AlexanderKnapik/DivaConGold/harness/samducksa_white.png

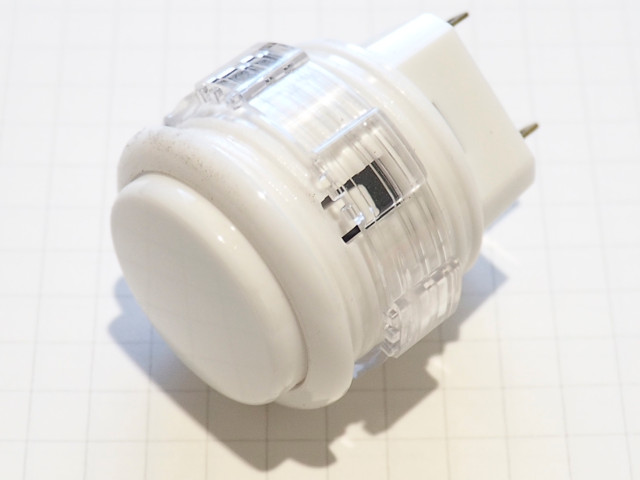
harness/samducksa_white.png
