AlexanderKnapik/DivaConGold/harness/samducksa_pink.png

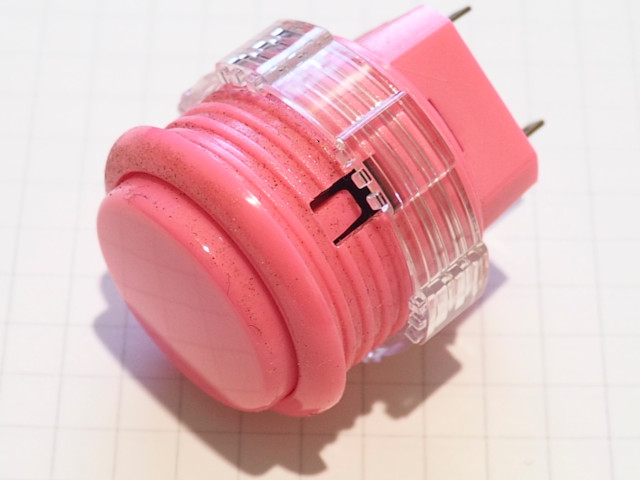
harness/samducksa_pink.png
