AlexanderKnapik/DivaConGold/harness/harness.png

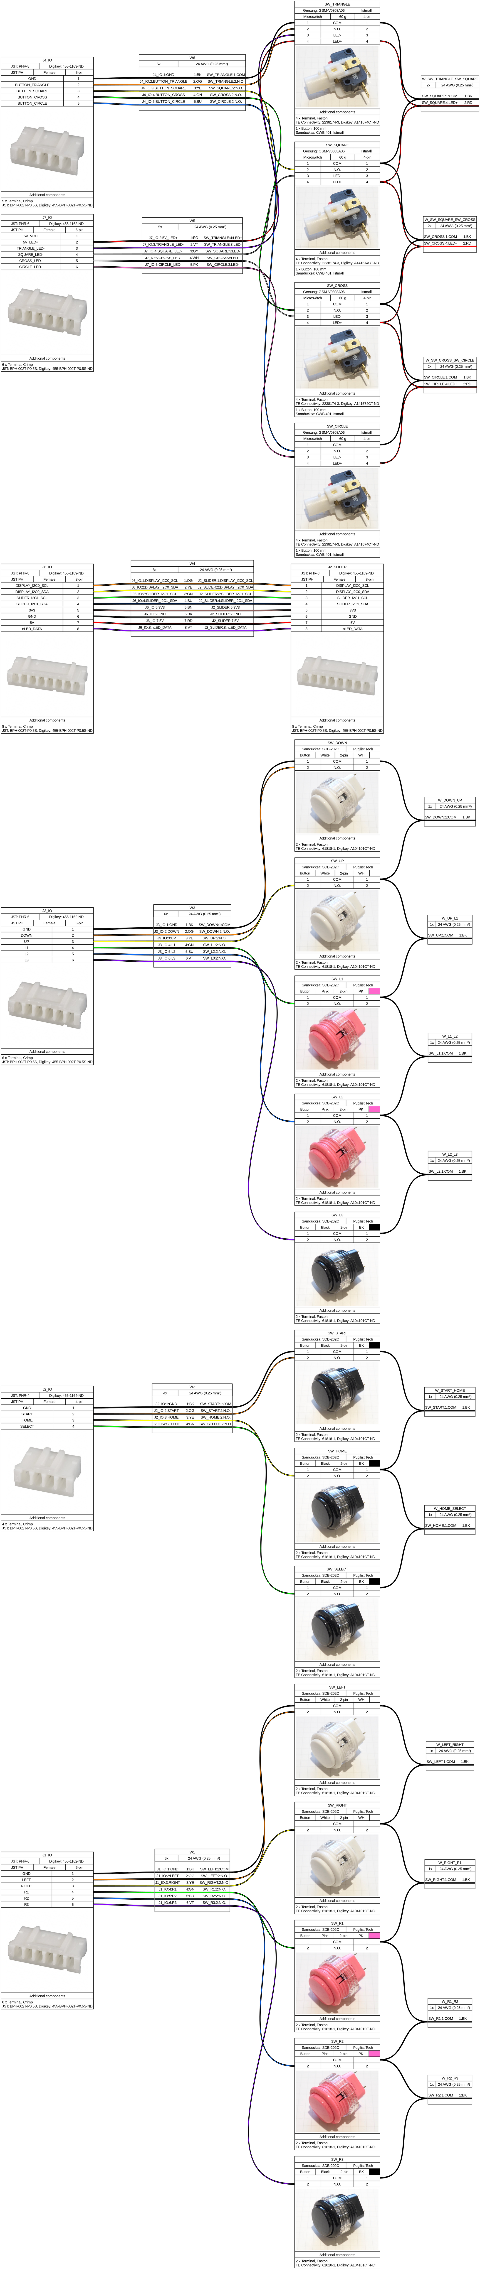
harness/harness.png
