AlexanderKnapik/DivaConGold/harness/microswitch.png

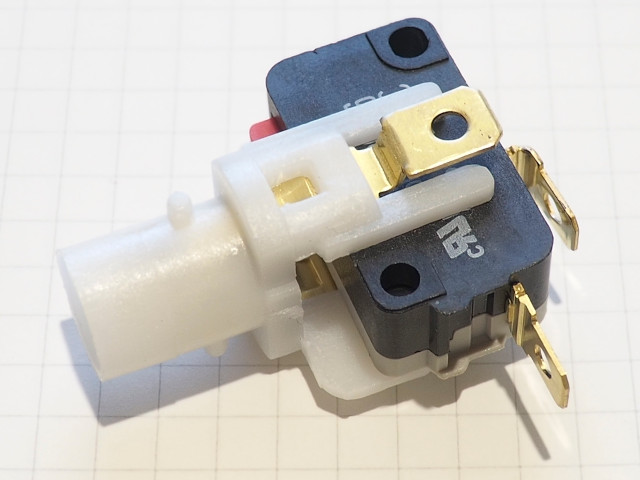
harness/microswitch.png
