AlexanderKnapik/DivaConGold/harness/samducksa_black.png

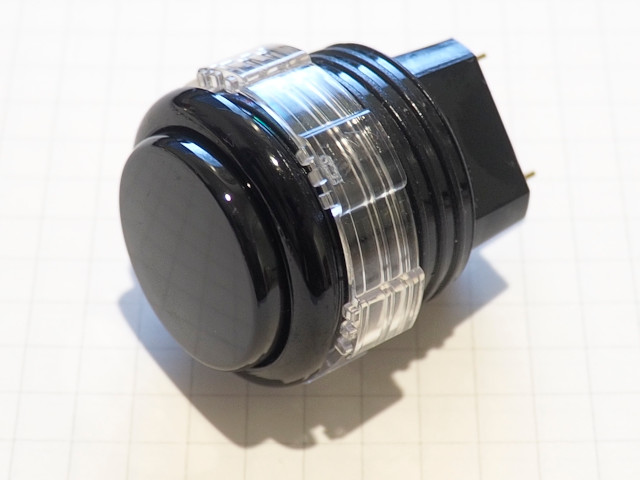
harness/samducksa_black.png
