AlexanderKnapik/DivaConGold/mech/DivaConGold.FCStd

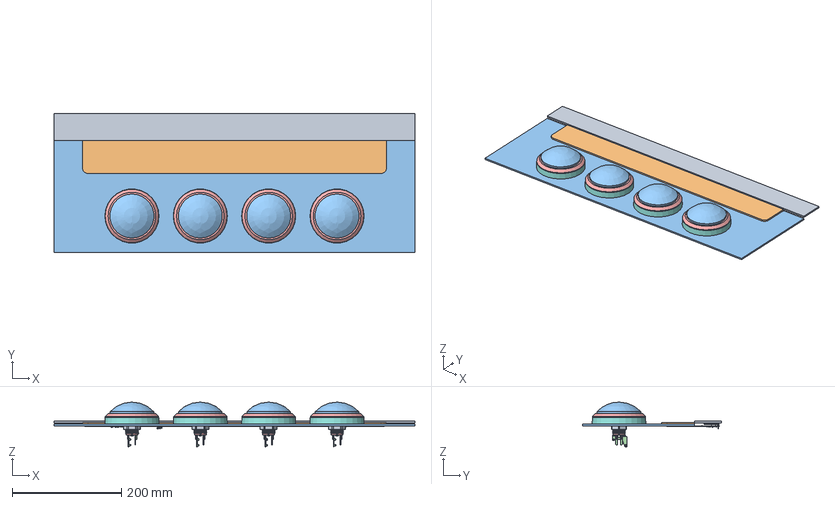
[picture p6: CAD file, 2025-12-05]
mech/DivaConGold.FCStd
660.0 x 255.0 x 82.0 mm
HeaderPlate
SliderPlate
FacePlate
C_0603_1608Metric
C_0603_1608Metric001
C_0603_1608Metric002
C_0603_1608Metric003
C_0603_1608Metric004
C_0603_1608Metric005
C_0603_1608Metric006
C_0603_1608Metric007
C_0603_1608Metric008
C_0603_1608Metric009
C_0603_1608Metric010
C_0603_1608Metric011
C_0603_1608Metric012
C_0603_1608Metric013
C_0603_1608Metric014
C_0603_1608Metric015
C_0603_1608Metric016
C_0603_1608Metric017
C_0603_1608Metric018
R_0603_1608Metric
C_0603_1608Metric019
C_0603_1608Metric020
C_0603_1608Metric021
C_0603_1608Metric022
C_0603_1608Metric023
C_0603_1608Metric024
C_0603_1608Metric025
C_0603_1608Metric026
C_0603_1608Metric027
C_0603_1608Metric028
C_0603_1608Metric029
C_0603_1608Metric030
C_0603_1608Metric031
C_0603_1608Metric032
C_0603_1608Metric033
C_0603_1608Metric034
C_0603_1608Metric035
C_0603_1608Metric036
C_0603_1608Metric037
C_0603_1608Metric038
C_0603_1608Metric039
C_0603_1608Metric040
C_0603_1608Metric041
C_0603_1608Metric042
C_0603_1608Metric043
C_0603_1608Metric044
C_0603_1608Metric045
C_0603_1608Metric046
C_0603_1608Metric047
C_0603_1608Metric048
C_0603_1608Metric049
C_0603_1608Metric050
C_0603_1608Metric051
C_0603_1608Metric052
C_0603_1608Metric053
C_0603_1608Metric054
C_0603_1608Metric055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
