AlexanderKnapik/DivaConGold/pcb/DivaConSlider/DivaConSlider.kicad_pcb

## KiCad design pcb/DivaConSlider/DivaConSlider.kicad_pcb (2025-12-05)

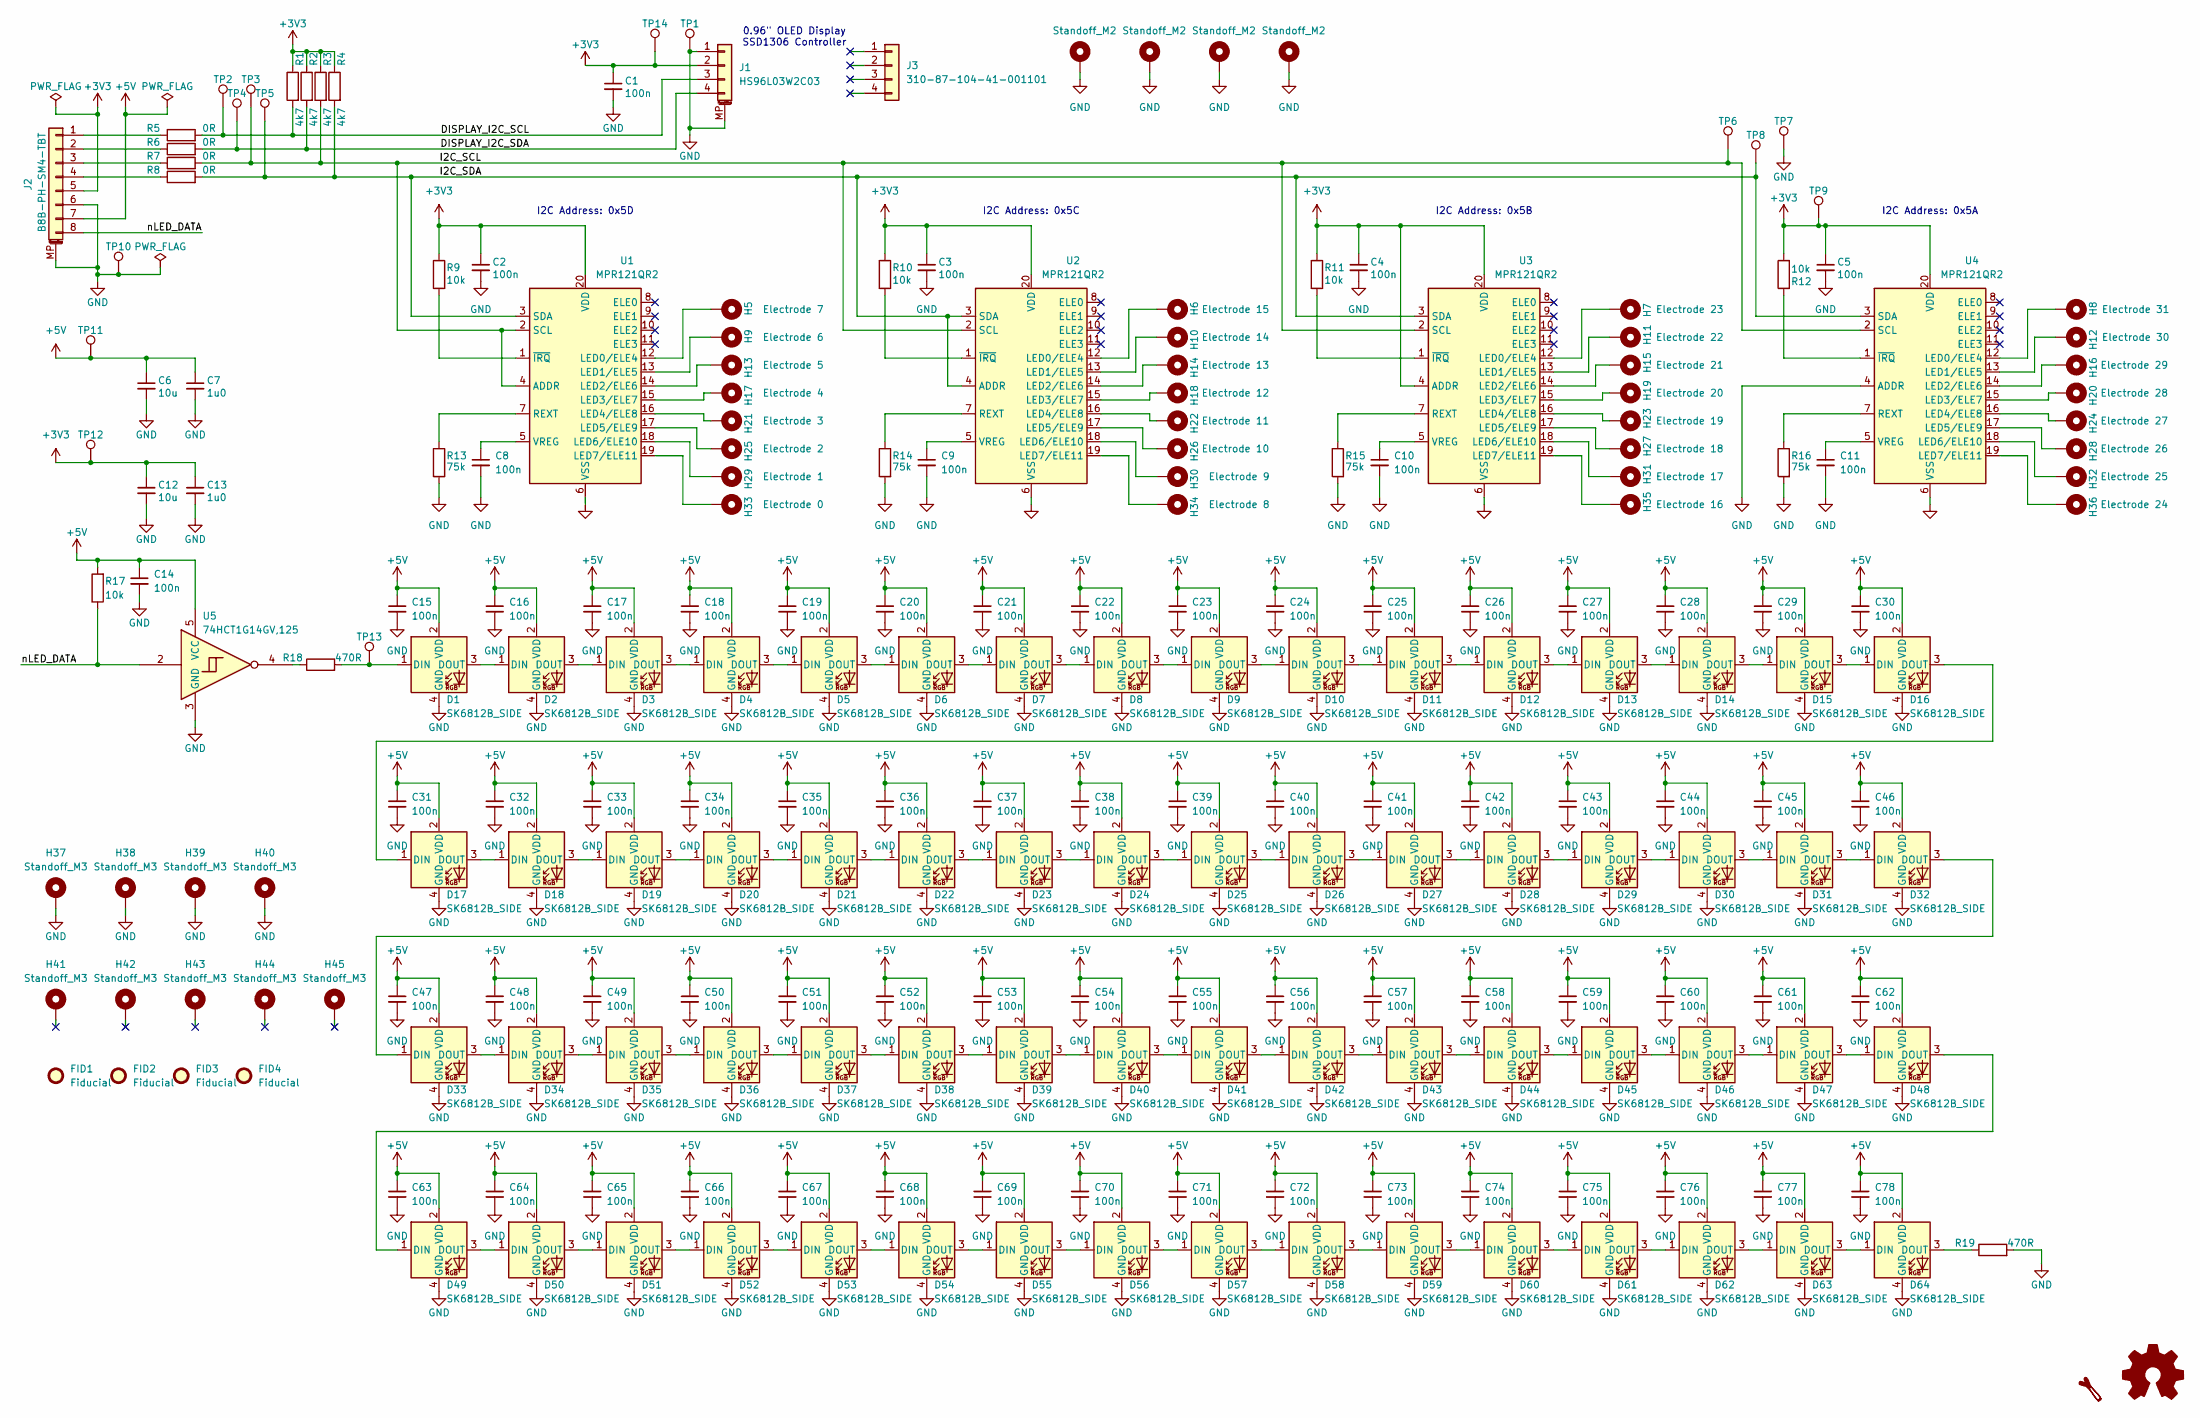
[picture p8: schematic DivaConSlider.kicad_sch, DivaConGold Slider]

Parts:
C1, C2, C3, C4, C5, C8, C9, C10, C11, C14, C15, C16, C17, C18, C19, C20, C21, C22, C23, C24, C25, C26, C27, C28, C29, C30, C31, C32, C33, C34, C35, C36, C37, C38, C39, C40, C41, C42, C43, C44, C45, C46, C47, C48, C49, C50, C51, C52, C53, C54, C55, C56, C57, C58, C59, C60, C61, C62, C63, C64, C65, C66, C67, C68, C69, C70, C71, C72, C73, C74, C75, C76, C77, C78: 100n; C_0603_1608Metric; Voltage 50V; PartNumber CL10B104KB8NNNC
C6, C12: 10u; C_0805_2012Metric; Voltage 16V; PartNumber CL21B106KOQNNNE
C7, C13: 1u0; C_0603_1608Metric; Voltage 16V; PartNumber CL10B105KO8NNNC
D1, D2, D3, D4, D5, D6, D7, D8, D9, D10, D11, D12, D13, D14, D15, D16, D17, D18, D19, D20, D21, D22, D23, D24, D25, D26, D27, D28, D29, D30, D31, D32, D33, D34, D35, D36, D37, D38, D39, D40, D41, D42, D43, D44, D45, D46, D47, D48, D49, D50, D51, D52, D53, D54, D55, D56, D57, D58, D59, D60, D61, D62, D63, D64: SK6812B_SIDE; LED_SK6812B_SIDE; PartNumber SK6812SIDE-A
FID1, FID2, FID3, FID4: Fiducial; Fiducial_0.5mm_Mask1.5mm
H1, H2, H3, H4: Standoff_M2; MountingHole_2.2mm_M2_Pad
H5: Electrode 7; Touchpad_15mmx42mm
H6: Electrode 15; Touchpad_15mmx42mm
H7: Electrode 23; Touchpad_15mmx42mm
H8: Electrode 31; Touchpad_15mmx42mm
H9: Electrode 6; Touchpad_15mmx42mm
H10: Electrode 14; Touchpad_15mmx42mm
H11: Electrode 22; Touchpad_15mmx42mm
H12: Electrode 30; Touchpad_15mmx42mm
H13: Electrode 5; Touchpad_15mmx42mm
H14: Electrode 13; Touchpad_15mmx42mm
H15: Electrode 21; Touchpad_15mmx42mm
H16: Electrode 29; Touchpad_15mmx42mm
H17: Electrode 4; Touchpad_15mmx42mm
H18: Electrode 12; Touchpad_15mmx42mm
H19: Electrode 20; Touchpad_15mmx42mm
H20: Electrode 28; Touchpad_15mmx42mm
H21: Electrode 3; Touchpad_15mmx42mm
H22: Electrode 11; Touchpad_15mmx42mm
H23: Electrode 19; Touchpad_15mmx42mm
H24: Electrode 27; Touchpad_15mmx42mm
H25: Electrode 2; Touchpad_15mmx42mm
H26: Electrode 10; Touchpad_15mmx42mm
H27: Electrode 18; Touchpad_15mmx42mm
H28: Electrode 26; Touchpad_15mmx42mm
H29: Electrode 1; Touchpad_15mmx42mm
H30: Electrode 9; Touchpad_15mmx42mm
H31: Electrode 17; Touchpad_15mmx42mm
H32: Electrode 25; Touchpad_15mmx42mm
H33: Electrode 0; Touchpad_15mmx42mm
H34: Electrode 8; Touchpad_15mmx42mm
H35: Electrode 16; Touchpad_15mmx42mm
H36: Electrode 24; Touchpad_15mmx42mm
H37, H38, H39, H40: Standoff_M3; MountingHole_3.2mm_M3_Pad_Via
H41, H42, H43, H44, H45: Standoff_M3; MountingHole_3.2mm_M3_Pad
J1: HS96L03W2C03; Hansheng_HS96L03W2C03; PartNumber HS96L03W2C03
J2: B8B-PH-SM4-TBT; JST_PH_B8B-PH-SM4-TB_1x08-1MP_P2.00mm_Vertical; PartNumber B8B-PH-SM4-TBT
J3: 310-87-104-41-001101; PinHeader_1x04_P2.54mm_Vertical; PartNumber 310-87-104-41-001101
R1, R2, R3, R4: 4k7; R_0603_1608Metric; PartNumber RMCF0603FT4K70
R5, R6, R7, R8: 0R; R_0603_1608Metric; PartNumber RMCF0603ZT0R00
R9, R10, R11, R12, R17: 10k; R_0603_1608Metric; PartNumber RMCF0603FT10K0
R13, R14, R15, R16: 75k; R_0603_1608Metric; PartNumber RMCF0603FT75K0
R18: 470R; R_0603_1608Metric; PartNumber RMCF0603FT470R
R19: 470R; R_0603_1608Metric
SYM1: Logo_Open_Hardware_Small; OSHW-Logo_5.7x6mm_SilkScreen
SYM2: Leek; Leek-Logo_6.3mm_Silkscreen
TP1, TP2, TP3, TP4, TP5, TP6, TP7, TP8, TP9, TP10, TP11, TP12, TP13, TP14: TestPoint; TestPoint_Pad_D1.5mm
U1, U2, U3, U4: MPR121QR2; UQFN-20_3x3mm_P0.4mm; PartNumber MPR121QR2
U5: 74HCT1G14GV,125; SC-74A-5_1.55x2.9mm_P0.95mm; PartNumber 74HCT1G14GV,125

Connections:
+3V3: C1.1, C2.1, C3.1, C4.1, C5.1, C12.1, C13.1, J1.2, J2.5, R1.1, R2.1, R3.1, R4.1, R9.1, R10.1, R11.1, R12.2, TP9.1, TP12.1, TP14.1, U1.20 (VDD), U2.20 (VDD), U3.4 (ADDR), U3.20 (VDD), U4.20 (VDD)
+5V: C6.1, C7.1, C14.1, C15.1, C16.1, C17.1, C18.1, C19.1, C20.1, C21.1, C22.1, C23.1, C24.1, C25.1, C26.1, C27.1, C28.1, C29.1, C30.1, C31.1, C32.1, C33.1, C34.1, C35.1, C36.1, C37.1, C38.1, C39.1, C40.1, C41.1, C42.1, C43.1, C44.1, C45.1, C46.1, C47.1, C48.1, C49.1, C50.1, C51.1, C52.1, C53.1, C54.1, C55.1, C56.1, C57.1, C58.1, C59.1, C60.1, C61.1, C62.1, C63.1, C64.1, C65.1, C66.1, C67.1, C68.1, C69.1, C70.1, C71.1, C72.1, C73.1, C74.1, C75.1, C76.1, C77.1, C78.1, D1.2 (VDD), D2.2 (VDD), D3.2 (VDD), D4.2 (VDD), D5.2 (VDD), D6.2 (VDD), D7.2 (VDD), D8.2 (VDD), D9.2 (VDD), D10.2 (VDD), D11.2 (VDD), D12.2 (VDD), D13.2 (VDD), D14.2 (VDD), D15.2 (VDD), D16.2 (VDD), D17.2 (VDD), D18.2 (VDD), D19.2 (VDD), D20.2 (VDD), D21.2 (VDD), D22.2 (VDD), D23.2 (VDD), D24.2 (VDD), D25.2 (VDD), D26.2 (VDD), D27.2 (VDD), D28.2 (VDD), D29.2 (VDD), D30.2 (VDD), D31.2 (VDD), D32.2 (VDD), D33.2 (VDD), D34.2 (VDD), D35.2 (VDD), D36.2 (VDD), D37.2 (VDD), D38.2 (VDD), D39.2 (VDD), D40.2 (VDD), D41.2 (VDD), D42.2 (VDD), D43.2 (VDD), D44.2 (VDD), D45.2 (VDD), D46.2 (VDD), D47.2 (VDD), D48.2 (VDD), D49.2 (VDD), D50.2 (VDD), D51.2 (VDD), D52.2 (VDD), D53.2 (VDD), D54.2 (VDD), D55.2 (VDD), D56.2 (VDD), D57.2 (VDD), D58.2 (VDD), D59.2 (VDD), D60.2 (VDD), D61.2 (VDD), D62.2 (VDD), D63.2 (VDD), D64.2 (VDD), J2.7, R17.2, TP11.1, U5.5 (VCC)
/DISPLAY_I2C_SCL: J1.3, R1.2, R5.2, TP2.1
/DISPLAY_I2C_SDA: J1.4, R2.2, R6.2, TP4.1
/I2C_SCL: R3.2, R7.2, TP3.1, TP6.1, U1.2 (SCL), U1.4 (ADDR), U2.2 (SCL), U3.2 (SCL), U4.2 (SCL)
/I2C_SDA: R4.2, R8.2, TP5.1, TP8.1, U1.3 (SDA), U2.3 (SDA), U2.4 (ADDR), U3.3 (SDA), U4.3 (SDA)
/nLED_DATA: J2.8, R17.1, U5.2
GND: C1.2, C2.2, C3.2, C4.2, C5.2, C6.2, C7.2, C8.2, C9.2, C10.2, C11.2, C12.2, C13.2, C14.2, C15.2, C16.2, C17.2, C18.2, C19.2, C20.2, C21.2, C22.2, C23.2, C24.2, C25.2, C26.2, C27.2, C28.2, C29.2, C30.2, C31.2, C32.2, C33.2, C34.2, C35.2, C36.2, C37.2, C38.2, C39.2, C40.2, C41.2, C42.2, C43.2, C44.2, C45.2, C46.2, C47.2, C48.2, C49.2, C50.2, C51.2, C52.2, C53.2, C54.2, C55.2, C56.2, C57.2, C58.2, C59.2, C60.2, C61.2, C62.2, C63.2, C64.2, C65.2, C66.2, C67.2, C68.2, C69.2, C70.2, C71.2, C72.2, C73.2, C74.2, C75.2, C76.2, C77.2, C78.2, D1.4 (GND), D2.4 (GND), D3.4 (GND), D4.4 (GND), D5.4 (GND), D6.4 (GND), D7.4 (GND), D8.4 (GND), D9.4 (GND), D10.4 (GND), D11.4 (GND), D12.4 (GND), D13.4 (GND), D14.4 (GND), D15.4 (GND), D16.4 (GND), D17.4 (GND), D18.4 (GND), D19.4 (GND), D20.4 (GND), D21.4 (GND), D22.4 (GND), D23.4 (GND), D24.4 (GND), D25.4 (GND), D26.4 (GND), D27.4 (GND), D28.4 (GND), D29.4 (GND), D30.4 (GND), D31.4 (GND), D32.4 (GND), D33.4 (GND), D34.4 (GND), D35.4 (GND), D36.4 (GND), D37.4 (GND), D38.4 (GND), D39.4 (GND), D40.4 (GND), D41.4 (GND), D42.4 (GND), D43.4 (GND), D44.4 (GND), D45.4 (GND), D46.4 (GND), D47.4 (GND), D48.4 (GND), D49.4 (GND), D50.4 (GND), D51.4 (GND), D52.4 (GND), D53.4 (GND), D54.4 (GND), D55.4 (GND), D56.4 (GND), D57.4 (GND), D58.4 (GND), D59.4 (GND), D60.4 (GND), D61.4 (GND), D62.4 (GND), D63.4 (GND), D64.4 (GND), H1.1, H2.1, H3.1, H4.1, H37.1, H38.1, H39.1, H40.1, J1.1, J1.MP (MountPin), J2.6, J2.MP (MountPin), R13.2, R14.2, R15.2, R16.2, R19.2, TP1.1, TP7.1, TP10.1, U1.6 (VSS), U2.6 (VSS), U3.6 (VSS), U4.4 (ADDR), U4.6 (VSS), U5.3 (GND)
unnamed: D1.1 (DIN), R18.2, TP13.1
unnamed: D1.3 (DOUT), D2.1 (DIN)
unnamed: D2.3 (DOUT), D3.1 (DIN)
unnamed: D3.3 (DOUT), D4.1 (DIN)
unnamed: D4.3 (DOUT), D5.1 (DIN)
unnamed: D5.3 (DOUT), D6.1 (DIN)
unnamed: D6.3 (DOUT), D7.1 (DIN)
unnamed: D7.3 (DOUT), D8.1 (DIN)
unnamed: D8.3 (DOUT), D9.1 (DIN)
unnamed: D9.3 (DOUT), D10.1 (DIN)
unnamed: D10.3 (DOUT), D11.1 (DIN)
unnamed: D11.3 (DOUT), D12.1 (DIN)
unnamed: D12.3 (DOUT), D13.1 (DIN)
unnamed: D13.3 (DOUT), D14.1 (DIN)
unnamed: D14.3 (DOUT), D15.1 (DIN)
unnamed: D15.3 (DOUT), D16.1 (DIN)
unnamed: D16.3 (DOUT), D17.1 (DIN)
unnamed: D17.3 (DOUT), D18.1 (DIN)
unnamed: D18.3 (DOUT), D19.1 (DIN)
unnamed: D19.3 (DOUT), D20.1 (DIN)
unnamed: D20.3 (DOUT), D21.1 (DIN)
unnamed: D21.3 (DOUT), D22.1 (DIN)
unnamed: D22.3 (DOUT), D23.1 (DIN)
unnamed: D23.3 (DOUT), D24.1 (DIN)
unnamed: D24.3 (DOUT), D25.1 (DIN)
unnamed: D25.3 (DOUT), D26.1 (DIN)
unnamed: D26.3 (DOUT), D27.1 (DIN)
unnamed: D27.3 (DOUT), D28.1 (DIN)
unnamed: D28.3 (DOUT), D29.1 (DIN)
unnamed: D29.3 (DOUT), D30.1 (DIN)
unnamed: D30.3 (DOUT), D31.1 (DIN)
unnamed: D31.3 (DOUT), D32.1 (DIN)
unnamed: D32.3 (DOUT), D33.1 (DIN)
unnamed: D33.3 (DOUT), D34.1 (DIN)
unnamed: D34.3 (DOUT), D35.1 (DIN)
unnamed: D35.3 (DOUT), D36.1 (DIN)
unnamed: D36.3 (DOUT), D37.1 (DIN)
unnamed: D37.3 (DOUT), D38.1 (DIN)
unnamed: D38.3 (DOUT), D39.1 (DIN)
unnamed: D39.3 (DOUT), D40.1 (DIN)
unnamed: D40.3 (DOUT), D41.1 (DIN)
unnamed: D41.3 (DOUT), D42.1 (DIN)
unnamed: D42.3 (DOUT), D43.1 (DIN)
unnamed: D43.3 (DOUT), D44.1 (DIN)
unnamed: D44.3 (DOUT), D45.1 (DIN)
unnamed: D45.3 (DOUT), D46.1 (DIN)
unnamed: D46.3 (DOUT), D47.1 (DIN)
unnamed: D47.3 (DOUT), D48.1 (DIN)
unnamed: D48.3 (DOUT), D49.1 (DIN)
unnamed: D49.3 (DOUT), D50.1 (DIN)
unnamed: D50.3 (DOUT), D51.1 (DIN)
unnamed: D51.3 (DOUT), D52.1 (DIN)
unnamed: D52.3 (DOUT), D53.1 (DIN)
unnamed: D53.3 (DOUT), D54.1 (DIN)
unnamed: D54.3 (DOUT), D55.1 (DIN)
unnamed: D55.3 (DOUT), D56.1 (DIN)
unnamed: D56.3 (DOUT), D57.1 (DIN)
unnamed: D57.3 (DOUT), D58.1 (DIN)
unnamed: D58.3 (DOUT), D59.1 (DIN)
unnamed: D59.3 (DOUT), D60.1 (DIN)
unnamed: D60.3 (DOUT), D61.1 (DIN)
unnamed: D61.3 (DOUT), D62.1 (DIN)
unnamed: D62.3 (DOUT), D63.1 (DIN)
unnamed: D63.3 (DOUT), D64.1 (DIN)
unnamed: D64.3 (DOUT), R19.1
unnamed: J2.1, R5.1
unnamed: J2.2, R6.1
unnamed: J2.3, R7.1
unnamed: J2.4, R8.1
unnamed: R18.1, U5.4
unnamed: H5.1, U1.12 (LED0/ELE4)
unnamed: H9.1, U1.13 (LED1/ELE5)
unnamed: H13.1, U1.14 (LED2/ELE6)
unnamed: H17.1, U1.15 (LED3/ELE7)
unnamed: H21.1, U1.16 (LED4/ELE8)
unnamed: H25.1, U1.17 (LED5/ELE9)
unnamed: H29.1, U1.18 (LED6/ELE10)
unnamed: H33.1, U1.19 (LED7/ELE11)
unnamed: R13.1, U1.7 (REXT)
unnamed: C8.1, U1.5 (VREG)
unnamed: R9.2, U1.1 (~IRQ)
unnamed: H6.1, U2.12 (LED0/ELE4)
unnamed: H10.1, U2.13 (LED1/ELE5)
unnamed: H14.1, U2.14 (LED2/ELE6)
unnamed: H18.1, U2.15 (LED3/ELE7)
unnamed: H22.1, U2.16 (LED4/ELE8)
unnamed: H26.1, U2.17 (LED5/ELE9)
unnamed: H30.1, U2.18 (LED6/ELE10)
unnamed: H34.1, U2.19 (LED7/ELE11)
unnamed: R14.1, U2.7 (REXT)
unnamed: C9.1, U2.5 (VREG)
unnamed: R10.2, U2.1 (~IRQ)
unnamed: H7.1, U3.12 (LED0/ELE4)
unnamed: H11.1, U3.13 (LED1/ELE5)
unnamed: H15.1, U3.14 (LED2/ELE6)
unnamed: H19.1, U3.15 (LED3/ELE7)
unnamed: H23.1, U3.16 (LED4/ELE8)
unnamed: H27.1, U3.17 (LED5/ELE9)
unnamed: H31.1, U3.18 (LED6/ELE10)
unnamed: H35.1, U3.19 (LED7/ELE11)
unnamed: R15.1, U3.7 (REXT)
unnamed: C10.1, U3.5 (VREG)
unnamed: R11.2, U3.1 (~IRQ)
unnamed: H8.1, U4.12 (LED0/ELE4)
unnamed: H12.1, U4.13 (LED1/ELE5)
unnamed: H16.1, U4.14 (LED2/ELE6)
unnamed: H20.1, U4.15 (LED3/ELE7)
unnamed: H24.1, U4.16 (LED4/ELE8)
unnamed: H28.1, U4.17 (LED5/ELE9)
unnamed: H32.1, U4.18 (LED6/ELE10)
unnamed: H36.1, U4.19 (LED7/ELE11)
unnamed: R16.1, U4.7 (REXT)
unnamed: C11.1, U4.5 (VREG)
unnamed: R12.1, U4.1 (~IRQ)

Notes on the sheet:
I2C Address: 0x5B
I2C Address: 0x5C
I2C Address: 0x5D
I2C Address: 0x5A
0.96" OLED Display SSD1306 Controller

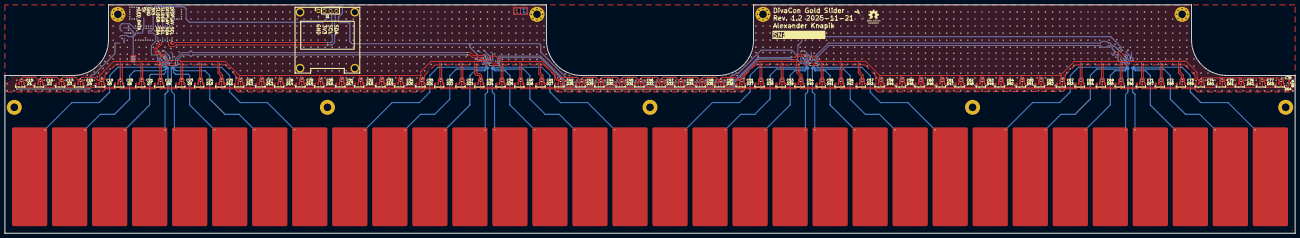
[picture p9: board DivaConSlider.kicad_pcb from above]

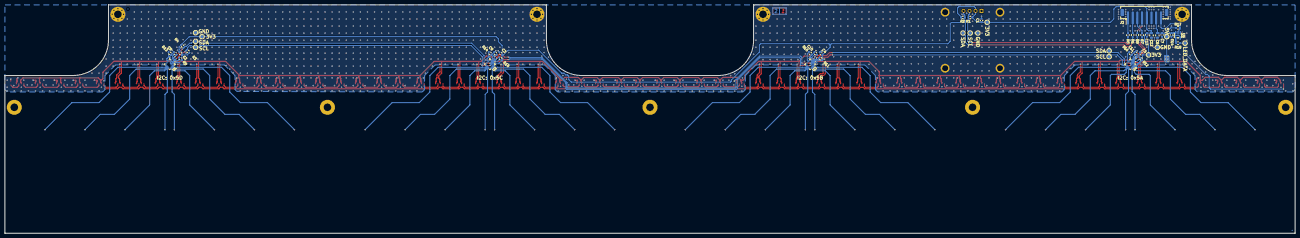
[picture p10: board DivaConSlider.kicad_pcb from below]

Board: 2 copper layers, 548.0 x 97.0 mm, 229 parts (54 on the bottom side), 122 nets.
