AlexanderKnapik/DivaConGold/pcb/DivaConIO/DivaConIO.kicad_pcb

## KiCad design pcb/DivaConIO/DivaConIO.kicad_pcb (2025-12-05)

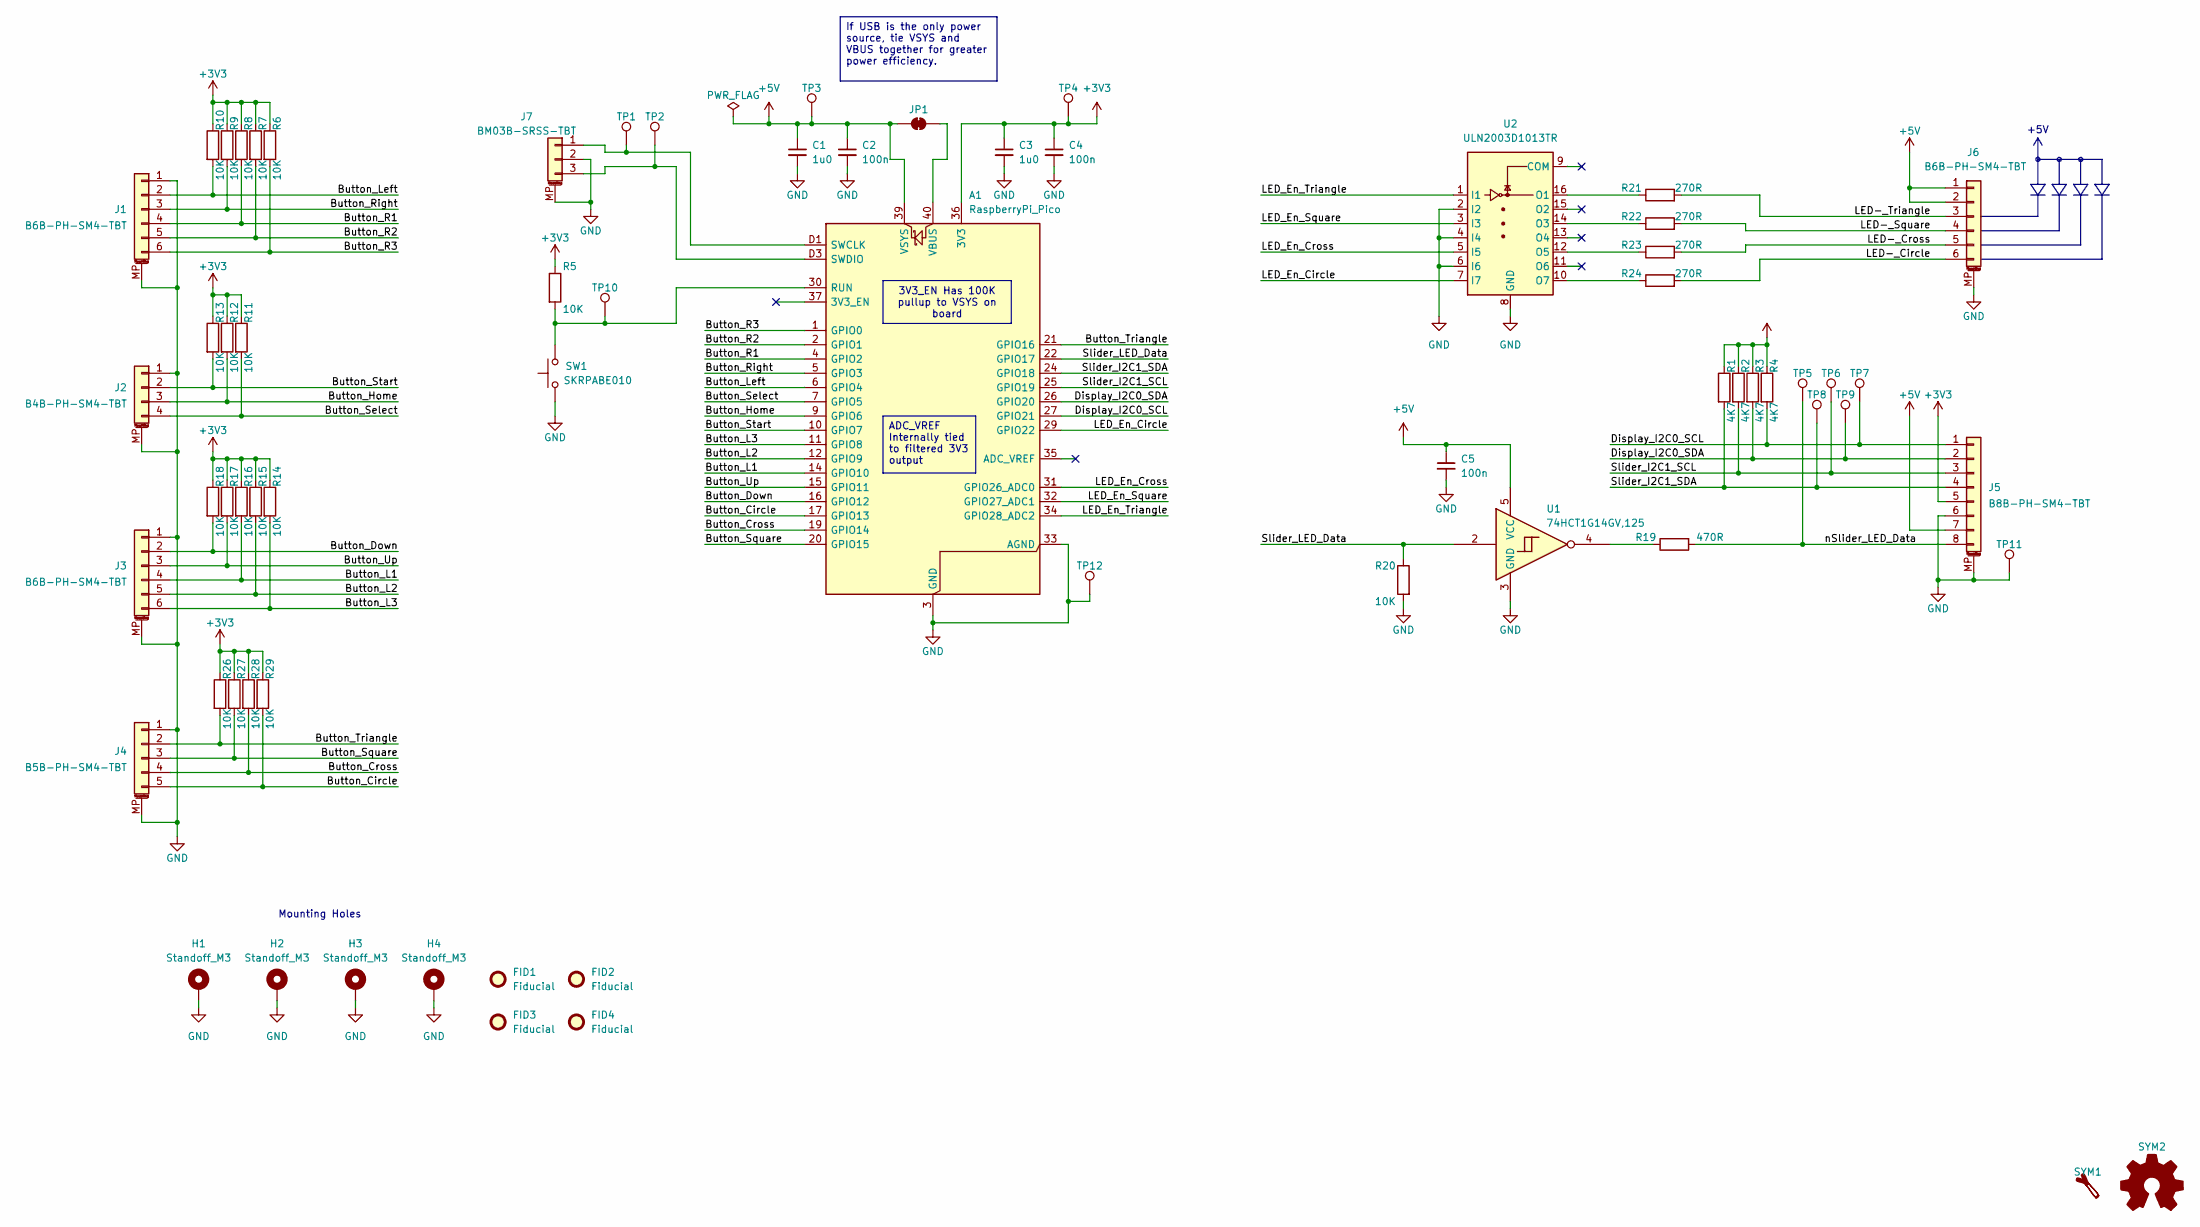
[picture p11: schematic DivaConIO.kicad_sch]

Parts:
A1: RaspberryPi_Pico; RaspberryPi_Pico_SMD_HandSolder; PartNumber SC0915
C1, C3: 1u0; C_0603_1608Metric; Voltage 16V; PartNumber CL10B105KO8NNNC
C2, C4, C5: 100n; C_0603_1608Metric; Voltage 50V; PartNumber CL10B104KB8NNNC
FID1, FID2, FID3, FID4: Fiducial; Fiducial_0.5mm_Mask1.5mm
H1, H2, H3, H4: Standoff_M3; MountingHole_3.2mm_M3_Pad_Via
J1, J3, J6: B6B-PH-SM4-TBT; JST_PH_B6B-PH-SM4-TB_1x06-1MP_P2.00mm_Vertical; PartNumber B6B-PH-SM4-TBT
J2: B4B-PH-SM4-TBT; JST_PH_B4B-PH-SM4-TB_1x04-1MP_P2.00mm_Vertical; PartNumber B4B-PH-SM4-TBT
J4: B5B-PH-SM4-TBT; JST_PH_B5B-PH-SM4-TB_1x05-1MP_P2.00mm_Vertical; PartNumber B5B-PH-SM4-TBT
J5: B8B-PH-SM4-TBT; JST_PH_B8B-PH-SM4-TB_1x08-1MP_P2.00mm_Vertical; PartNumber B8B-PH-SM4-TBT
J7: BM03B-SRSS-TBT; JST_SH_BM03B-SRSS-TB_1x03-1MP_P1.00mm_Vertical; PartNumber BM03B-SRSS-TBT
JP1: SolderJumper_2_Bridged; SolderJumper-2_P1.3mm_Bridged_RoundedPad1.0x1.5mm
R1, R2, R3, R4: 4K7; R_0603_1608Metric; PartNumber RMCF0603FT4K70
R5, R6, R7, R8, R9, R10, R11, R12, R13, R14, R15, R16, R17, R18, R20, R26, R27, R28, R29: 10K; R_0603_1608Metric; PartNumber RMCF0603FT10K0
R19: 470R; R_0603_1608Metric; PartNumber RMCF0603FT470R
R21, R22, R23, R24: 270R; R_1206_3216Metric; PartNumber RMCF1206JT270R
SW1: SKRPABE010; SW_Push_SPST_NO_Alps_SKRP; PartNumber SKRPABE010
SYM1: Leek; Leek-Logo_6.3mm_Silkscreen
SYM2: Logo_Open_Hardware_Small; OSHW-Logo2_7.3x6mm_SilkScreen
TP1, TP2, TP3, TP4, TP5, TP6, TP7, TP8, TP9, TP10, TP11, TP12: TestPoint; TestPoint_Pad_D2.0mm
U1: 74HCT1G14GV,125; SC-74A-5_1.55x2.9mm_P0.95mm; PartNumber 74HCT1G14GV,125
U2: ULN2003D1013TR; SOIC-16_3.9x9.9mm_P1.27mm; PartNumber ULN2003D1013TR

Connections:
+3V3: A1.36 (3V3), C3.1, C4.1, J5.5, R1.1, R2.1, R3.1, R4.1, R5.1, R6.1, R7.1, R8.1, R9.1, R10.1, R11.1, R12.1, R13.1, R14.1, R15.1, R16.1, R17.1, R18.1, R26.1, R27.1, R28.1, R29.1, TP4.1
+5V: A1.39 (VSYS), C1.1, C2.1, C5.1, J5.7, J6.1, J6.2, JP1.1 (A), TP3.1, U1.5 (VCC)
/Button_Circle: A1.17 (GPIO13), J4.5, R29.2
/Button_Cross: A1.19 (GPIO14), J4.4, R28.2
/Button_Down: A1.16 (GPIO12), J3.2, R18.2
/Button_Home: A1.9 (GPIO6), J2.3, R12.2
/Button_L1: A1.14 (GPIO10), J3.4, R16.2
/Button_L2: A1.12 (GPIO9), J3.5, R15.2
/Button_L3: A1.11 (GPIO8), J3.6, R14.2
/Button_Left: A1.6 (GPIO4), J1.2, R10.2
/Button_R1: A1.4 (GPIO2), J1.4, R8.2
/Button_R2: A1.2 (GPIO1), J1.5, R7.2
/Button_R3: A1.1 (GPIO0), J1.6, R6.2
/Button_Right: A1.5 (GPIO3), J1.3, R9.2
/Button_Select: A1.7 (GPIO5), J2.4, R11.2
/Button_Square: A1.20 (GPIO15), J4.3, R27.2
/Button_Start: A1.10 (GPIO7), J2.2, R13.2
/Button_Triangle: A1.21 (GPIO16), J4.2, R26.2
/Button_Up: A1.15 (GPIO11), J3.3, R17.2
/Display_I2C0_SCL: A1.27 (GPIO21), J5.1, R4.2, TP7.1
/Display_I2C0_SDA: A1.26 (GPIO20), J5.2, R3.2, TP9.1
/LED-_Circle: J6.6, R24.2
/LED-_Cross: J6.5, R23.2
/LED-_Square: J6.4, R22.2
/LED-_Triangle: J6.3, R21.2
/LED_En_Circle: A1.29 (GPIO22), U2.7 (I7)
/LED_En_Cross: A1.31 (GPIO26_ADC0), U2.5 (I5)
/LED_En_Square: A1.32 (GPIO27_ADC1), U2.3 (I3)
/LED_En_Triangle: A1.34 (GPIO28_ADC2), U2.1 (I1)
/Slider_I2C1_SCL: A1.25 (GPIO19), J5.3, R2.2, TP6.1
/Slider_I2C1_SDA: A1.24 (GPIO18), J5.4, R1.2, TP8.1
/Slider_LED_Data: A1.22 (GPIO17), R20.1, U1.2
/nSlider_LED_Data: J5.8, R19.2, TP5.1
GND: A1.3 (GND), A1.8 (GND), A1.13 (GND), A1.18 (GND), A1.23 (GND), A1.28 (GND), A1.33 (AGND), A1.38 (GND), A1.D2 (GND), C1.2, C2.2, C3.2, C4.2, C5.2, H1.1, H2.1, H3.1, H4.1, J1.1, J1.MP (MountPin), J2.1, J2.MP (MountPin), J3.1, J3.MP (MountPin), J4.1, J4.MP (MountPin), J5.6, J5.MP (MountPin), J6.MP (MountPin), J7.2, J7.MP (MountPin), R20.2, SW1.1, TP11.1, TP12.1, U1.3 (GND), U2.2 (I2), U2.4 (I4), U2.6 (I6), U2.8 (GND)
unnamed: A1.30 (RUN), R5.2, SW1.2, TP10.1
unnamed: A1.D1 (SWCLK), J7.1, TP1.1
unnamed: A1.D3 (SWDIO), J7.3, TP2.1
unnamed: A1.40 (VBUS), JP1.2 (B)
unnamed: R19.1, U1.4
unnamed: R21.1, U2.16 (O1)
unnamed: R22.1, U2.14 (O3)
unnamed: R23.1, U2.12 (O5)
unnamed: R24.1, U2.10 (O7)

Notes on the sheet:
Mounting Holes
+5V
ADC_VREF Internally tied to filtered 3V3 output
If USB is the only power source, tie VSYS and VBUS together for greater power efficiency.
3V3_EN Has 100K pullup to VSYS on board

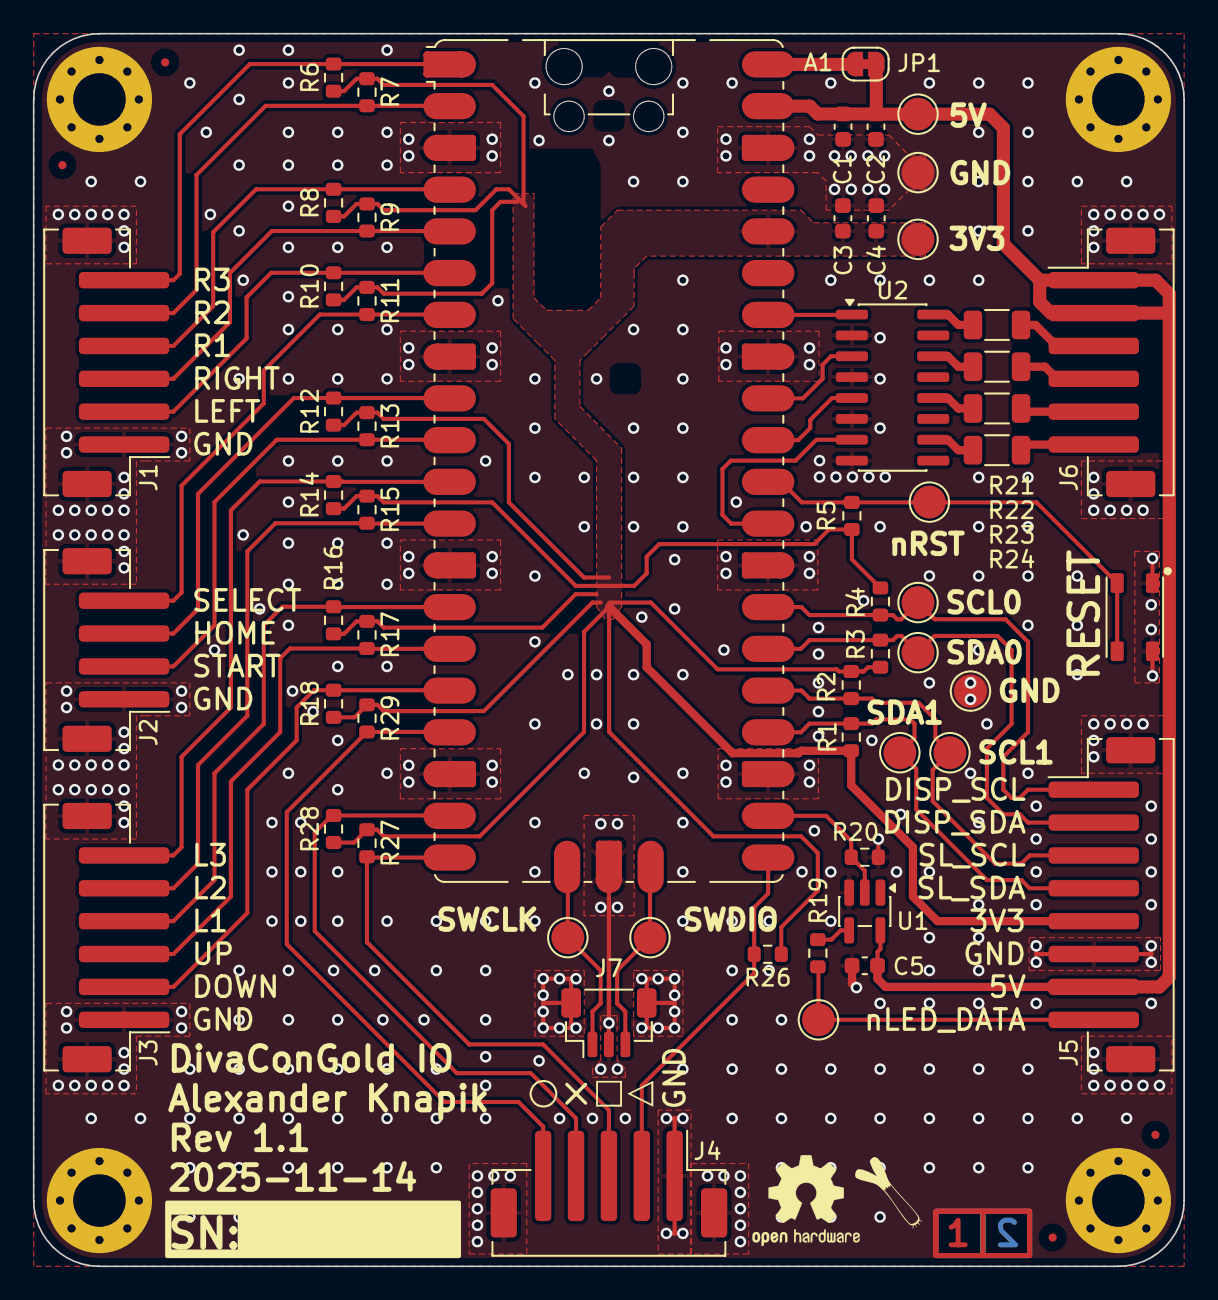
[picture p12: board DivaConIO.kicad_pcb from above]

Board: 2 copper layers, 70.0 x 75.0 mm, 67 parts (0 on the bottom side), 43 nets.
