AlexanderKnapik/DivaConGold/src/tusb_config.h

#ifndef TUSB_CONFIG_H_
#define TUSB_CONFIG_H_

#ifdef __cplusplus
extern "C" {
#endif

#include "pico/stdio_usb.h"

//--------------------------------------------------------------------+
// Board Specific Configuration
//--------------------------------------------------------------------+
// RHPort number used for device can be defined by board.mk, default to port 0
#ifndef BOARD_TUD_RHPORT
#define BOARD_TUD_RHPORT (0)
#endif

#ifndef BOARD_TUD_MAX_SPEED
#define BOARD_TUD_MAX_SPEED OPT_MODE_DEFAULT_SPEED
#endif

#if !defined(LIB_TINYUSB_HOST) && !defined(LIB_TINYUSB_DEVICE)
#define CFG_TUSB_RHPORT0_MODE (OPT_MODE_DEVICE)

//--------------------------------------------------------------------
// COMMON CONFIGURATION
//--------------------------------------------------------------------
#ifndef CFG_TUSB_DEBUG
#define CFG_TUSB_DEBUG (1)
#endif

#define CFG_TUD_ENABLED (1)

// Default is max speed that hardware controller could support with on-chip PHY
#define CFG_TUD_MAX_SPEED BOARD_TUD_MAX_SPEED

//--------------------------------------------------------------------
// DEVICE CONFIGURATION
//--------------------------------------------------------------------

//------------- CLASS -------------//
#define CFG_TUD_CDC (1)

#define CFG_TUD_MSC (0)
#define CFG_TUD_MIDI (1)
// #define CFG_TUD_HID (1)

//-------- CLASS BUFFER SIZES -------//

// CDC FIFO size of TX and RX
#define CFG_TUD_CDC_RX_BUFSIZE (TUD_OPT_HIGH_SPEED ? 512 : 64)
#define CFG_TUD_CDC_TX_BUFSIZE (TUD_OPT_HIGH_SPEED ? 512 : 64)
// CDC Endpoint transfer buffer size, more is faster
#define CFG_TUD_CDC_EP_BUFSIZE (TUD_OPT_HIGH_SPEED ? 512 : 64)

#define CFG_TUD_HID_EP_BUFSIZE (64)

#define CFG_TUD_MIDI_RX_BUFSIZE (TUD_OPT_HIGH_SPEED ? 512 : 64)
#define CFG_TUD_MIDI_TX_BUFSIZE (TUD_OPT_HIGH_SPEED ? 512 : 64)
#define CFG_TUD_MIDI_EP_BUFSIZE (TUD_OPT_HIGH_SPEED ? 512 : 64)

// We use a vendor specific interface but with our own driver
// Vendor driver only used for Microsoft OS 2.0 descriptor
#if !PICO_STDIO_USB_RESET_INTERFACE_SUPPORT_MS_OS_20_DESCRIPTOR
#define CFG_TUD_VENDOR (0)
#else
#define CFG_TUD_VENDOR (1)
#define CFG_TUD_VENDOR_RX_BUFSIZE (256)
#define CFG_TUD_VENDOR_TX_BUFSIZE (256)
#endif

#endif

#ifdef __cplusplus
}
#endif

#endif // TUSB_CONFIG_H_
