AlexanderKnapik/DivaConGold/src/peripherals/TouchSliderLeds.cpp

#include "peripherals/TouchSliderLeds.h"

#include "pico/rand.h"
#include "pio_ws2812/ws2812.h"

#include <algorithm>

namespace Divacon::Peripherals {

namespace {

// Use alternating frames to allow for smoother animation
const size_t RAINBOW_LENGTH = 40;

// NOLINTBEGIN(modernize-use-designated-initializers)
const std::array<std::array<TouchSliderLeds::Config::Color, RAINBOW_LENGTH>, 2> rainbow_colors{{
    {{
        {0x5a, 0x3a, 0xc6}, {0x76, 0x36, 0xaa}, {0x91, 0x34, 0x8e}, {0xad, 0x30, 0x72}, {0xca, 0x2e, 0x56},
        {0xe6, 0x2a, 0x3a}, {0xf2, 0x2f, 0x2b}, {0xe6, 0x42, 0x33}, {0xce, 0x5c, 0x46}, {0xb6, 0x74, 0x59},
        {0x9e, 0x8d, 0x6c}, {0x86, 0xa6, 0x7e}, {0x6e, 0xbf, 0x90}, {0x57, 0xd8, 0xa3}, {0x4c, 0xea, 0xac},
        {0x58, 0xf0, 0xa3}, {0x6d, 0xf0, 0x92}, {0x83, 0xf0, 0x82}, {0x99, 0xf0, 0x72}, {0xae, 0xf0, 0x61},
        {0xc4, 0xf0, 0x50}, {0xdb, 0xf0, 0x40}, {0xec, 0xea, 0x34}, {0xf2, 0xdc, 0x34}, {0xf4, 0xc9, 0x38},
        {0xf6, 0xb6, 0x3c}, {0xf8, 0xa2, 0x40}, {0xfa, 0x90, 0x45}, {0xfc, 0x7d, 0x49}, {0xfe, 0x6a, 0x4d},
        {0xf8, 0x5c, 0x56}, {0xe2, 0x56, 0x68}, {0xc6, 0x52, 0x7d}, {0xaa, 0x50, 0x93}, {0x8e, 0x4c, 0xa9},
        {0x72, 0x4a, 0xbf}, {0x56, 0x46, 0xd5}, {0x3a, 0x44, 0xeb}, {0x2e, 0x40, 0xf3}, {0x3e, 0x3c, 0xe2},
    }},
    {{
        {0x68, 0x38, 0xb7}, {0x83, 0x35, 0x9c}, {0x9f, 0x32, 0x80}, {0xbb, 0x2f, 0x64}, {0xd8, 0x2c, 0x48},
        {0xf3, 0x29, 0x2c}, {0xf2, 0x35, 0x2a}, {0xda, 0x4f, 0x3c}, {0xc3, 0x68, 0x50}, {0xaa, 0x81, 0x62},
        {0x92, 0x99, 0x75}, {0x7a, 0xb2, 0x87}, {0x63, 0xcc, 0x9a}, {0x4b, 0xe5, 0xac}, {0x4d, 0xf0, 0xab},
        {0x62, 0xf0, 0x9b}, {0x78, 0xf0, 0x8a}, {0x8e, 0xf0, 0x7a}, {0xa4, 0xf0, 0x69}, {0xb9, 0xf0, 0x59},
        {0xd0, 0xf0, 0x48}, {0xe6, 0xf0, 0x37}, {0xf1, 0xe5, 0x32}, {0xf3, 0xd2, 0x36}, {0xf5, 0xc0, 0x3a},
        {0xf7, 0xac, 0x3e}, {0xf9, 0x99, 0x43}, {0xfb, 0x86, 0x47}, {0xfd, 0x74, 0x4b}, {0xff, 0x61, 0x4f},
        {0xf0, 0x57, 0x5d}, {0xd4, 0x54, 0x72}, {0xb7, 0x51, 0x88}, {0x9c, 0x4e, 0x9e}, {0x80, 0x4b, 0xb4},
        {0x64, 0x48, 0xca}, {0x48, 0x45, 0xe0}, {0x2c, 0x42, 0xf6}, {0x2f, 0x3e, 0xf0}, {0x4c, 0x3b, 0xd4},
    }},
}};
// NOLINTEND(modernize-use-designated-initializers)

TouchSliderLeds::Config::Color dim_color(const TouchSliderLeds::Config::Color &color, float dim_factor) {
    return TouchSliderLeds::Config::Color{
        .r = (uint8_t)((float)color.r * dim_factor),
        .g = (uint8_t)((float)color.g * dim_factor),
        .b = (uint8_t)((float)color.b * dim_factor),
    };
}

TouchSliderLeds::Config::Color max_color(const TouchSliderLeds::Config::Color &a,
                                         const TouchSliderLeds::Config::Color &b) {
    return TouchSliderLeds::Config::Color{
        .r = std::max(a.r, b.r),
        .g = std::max(a.g, b.g),
        .b = std::max(a.b, b.b),
    };
}

} // namespace

uint32_t TouchSliderLeds::AnimationStepper::getFrameCount(uint32_t steps) {
    m_current_steps += steps;
    if (m_current_steps < m_steps_until_advance) {
        return 0;
    }

    const auto frames = m_current_steps / m_steps_until_advance;
    m_current_steps %= m_steps_until_advance;

    return frames;
}

TouchSliderLeds::TouchSliderLeds(const Config &config) : m_config(config) {
    m_rendered_frame = std::vector<uint32_t>(32 * config.leds_per_segment, ws2812_rgb_to_u32pixel(0, 0, 0));

    m_rainbow_state.position = get_rand_32() % RAINBOW_LENGTH;

    ws2812_init(pio0, config.led_pin, m_config.is_rgbw);
}

void TouchSliderLeds::setBrightness(uint8_t brightness) { m_config.brightness = brightness; }
void TouchSliderLeds::setAnimationSpeed(uint8_t speed) { m_config.animation_speed = speed; };
void TouchSliderLeds::setIdleMode(Config::IdleMode mode) { m_config.idle_mode = mode; };
void TouchSliderLeds::setTouchedMode(Config::TouchedMode mode) { m_config.touched_mode = mode; };
void TouchSliderLeds::setIdleColor(const Config::Color &color) { m_config.idle_color = color; };
void TouchSliderLeds::setTouchedColor(const Config::Color &color) { m_config.touched_color = color; };
void TouchSliderLeds::setEnablePlayerColor(bool do_enable) { m_config.enable_player_color = do_enable; };
void TouchSliderLeds::setEnablePdloaderSupport(bool do_enable) { m_config.enable_pdloader_support = do_enable; };

void TouchSliderLeds::setTouched(uint32_t touched) { m_touched = touched; }
void TouchSliderLeds::setPlayerColor(const TouchSliderLeds::Config::Color &color) { m_player_color = color; }

void TouchSliderLeds::updateIdle(uint32_t steps) {
    if (steps <= 0) {
        return;
    }

    // Check for player color
    const auto idle_color =
        m_config.enable_player_color ? m_player_color.value_or(m_config.idle_color) : m_config.idle_color;

    switch (m_config.idle_mode) {
    case Config::IdleMode::Off:
        m_idle_buffer.fill({.r = 0x00, .g = 0x00, .b = 0x00});
        break;
    case Config::IdleMode::Static:
        m_idle_buffer.fill(idle_color);
        break;
    case Config::IdleMode::Pulse: {
        const auto advance = m_pulse_state.stepper.getFrameCount(steps);

        if (m_pulse_state.advance_factor < 0 && advance >= (uint8_t)(m_pulse_state.dim_percent - PULSE_DIM_PCT_MIN)) {
            m_pulse_state.dim_percent = PULSE_DIM_PCT_MIN;
            m_pulse_state.advance_factor = (int8_t)(-m_pulse_state.advance_factor);
        } else if (m_pulse_state.advance_factor > 0 && advance + m_pulse_state.dim_percent >= PULSE_DIM_PCT_MAX) {
            m_pulse_state.dim_percent = PULSE_DIM_PCT_MAX;
            m_pulse_state.advance_factor = (int8_t)(-m_pulse_state.advance_factor);
        } else {
            m_pulse_state.dim_percent += (m_pulse_state.advance_factor * advance);
        }

        m_idle_buffer.fill(dim_color(idle_color, (float)m_pulse_state.dim_percent / 100.F));
    } break;
    case Config::IdleMode::RainbowCycle:
        m_rainbow_state.position = (m_rainbow_state.position + m_rainbow_state.stepper.getFrameCount(steps)) %
                                   (RAINBOW_LENGTH * rainbow_colors.size());
        [[fallthrough]];
    case Config::IdleMode::RainbowStatic: {
        const auto frame = m_rainbow_state.position % rainbow_colors.size();
        const auto frame_position = m_rainbow_state.position / rainbow_colors.size();

        for (size_t idx = 0; idx < m_idle_buffer.size(); ++idx) {
            const size_t offset = (frame_position + idx) % RAINBOW_LENGTH;
            m_idle_buffer.at(idx) = rainbow_colors.at(frame).at(offset);
        }
    } break;
    }
}
void TouchSliderLeds::updateTouched(uint32_t steps) {
    switch (m_config.touched_mode) {
    case Config::TouchedMode::Off:
        m_touched_buffer.fill({.r = 0x00, .g = 0x00, .b = 0x00});
        break;
    case Config::TouchedMode::Idle:
        std::ranges::copy(m_idle_buffer, m_touched_buffer.begin());
        break;
    case Config::TouchedMode::Touched:
        for (size_t idx = 0; idx < SEGMENT_COUNT; ++idx) {
            if ((m_touched & ((uint32_t)0x80000000 >> idx)) != 0) {
                m_touched_buffer.at(idx) = m_config.touched_color;
            } else {
                m_touched_buffer.at(idx) = {.r = 0x00, .g = 0x00, .b = 0x00};
            }
        }
        break;
    case Config::TouchedMode::TouchedFade: {
        const auto advance = m_fade_state.stepper.getFrameCount(steps);

        for (size_t idx = 0; idx < SEGMENT_COUNT; ++idx) {
            if ((m_touched & ((uint32_t)0x80000000 >> idx)) != 0) {
                m_touched_buffer.at(idx) = m_config.touched_color;
                m_fade_state.percent.at(idx) = 100;
            } else {
                m_touched_buffer.at(idx) =
                    dim_color(m_touched_buffer.at(idx), (float)m_fade_state.percent.at(idx) / 100.F);
                m_fade_state.percent.at(idx) =
                    advance > m_fade_state.percent.at(idx) ? 0 : m_fade_state.percent.at(idx) - advance;
            }
        }
    } break;
    case Config::TouchedMode::TouchedIdle: {
        const auto advance = m_fade_state.stepper.getFrameCount(steps);

        for (size_t idx = 0; idx < SEGMENT_COUNT; ++idx) {
            if ((m_touched & ((uint32_t)0x80000000 >> idx)) != 0) {
                m_touched_buffer.at(idx) = m_idle_buffer.at(idx);
                m_fade_state.percent.at(idx) = 100;
            } else {
                m_touched_buffer.at(idx) =
                    dim_color(m_touched_buffer.at(idx), (float)m_fade_state.percent.at(idx) / 100.F);
                m_fade_state.percent.at(idx) =
                    advance > m_fade_state.percent.at(idx) ? 0 : m_fade_state.percent.at(idx) - advance;
            }
        }
    } break;
    }
}

void TouchSliderLeds::render(uint32_t steps) {
    const auto blend_advance = m_blend_state.stepper.getFrameCount(steps);
    if (m_touched != 0) {
        m_blend_state.percent = blend_advance > m_blend_state.percent ? 0 : m_blend_state.percent - blend_advance;
    } else {
        m_blend_state.percent =
            blend_advance + m_blend_state.percent > 100 ? 100 : m_blend_state.percent + blend_advance;
    }

    const auto brightness_dim_factor = (float)m_config.brightness / 255.F;
    const auto blend_dim_factor = (float)m_blend_state.percent / 100.F;

    size_t idx = 0;
    for (auto &rendered_segment : m_rendered_frame) {
        auto blended_segment = max_color(dim_color(m_idle_buffer.at(idx / m_config.leds_per_segment), blend_dim_factor),
                                         m_touched_buffer.at(idx / m_config.leds_per_segment));

        rendered_segment = ws2812_rgb_to_u32pixel((uint8_t)((float)blended_segment.r * brightness_dim_factor),
                                                  (uint8_t)((float)blended_segment.g * brightness_dim_factor),
                                                  (uint8_t)((float)blended_segment.b * brightness_dim_factor));

        ++idx;
    }
}

void TouchSliderLeds::show() { ws2812_put_frame(pio0, m_rendered_frame.data(), m_rendered_frame.size()); }

void TouchSliderLeds::update() {
    const uint32_t now = to_ms_since_boot(get_absolute_time());
    const uint32_t elapsed = now - m_previous_frame_time;
    const uint32_t steps = elapsed * m_config.animation_speed;

    m_previous_frame_time = now;

    if (m_raw_mode && m_config.enable_pdloader_support) {
        return;
    }

    updateIdle(steps);
    updateTouched(steps);

    render(steps);
    show();
}

void TouchSliderLeds::update(const TouchSliderLeds::RawFrameMessage &frame) {
    if (!m_config.enable_pdloader_support) {
        return;
    }

    m_raw_mode = true;

    size_t idx = 0;
    for (const auto &color : frame) {
        for (uint16_t led = 0; led < m_config.leds_per_segment; ++led) {
            // Allow limiting max brightness to stay within USB power restrictions.
            const uint8_t color_max = std::max({color.r, color.g, color.b});
            if (color_max > m_config.brightness) {
                const auto dim_factor = (float)m_config.brightness / (float)color_max;
                m_rendered_frame.at((idx * m_config.leds_per_segment) + led) = ws2812_rgb_to_u32pixel(
                    (uint8_t)((float)color.r * dim_factor), (uint8_t)((float)color.g * dim_factor),
                    (uint8_t)((float)color.b * dim_factor));
            } else {
                m_rendered_frame.at((idx * m_config.leds_per_segment) + led) =
                    ws2812_rgb_to_u32pixel(color.r, color.g, color.b);
            }
        }
        ++idx;
    }

    ws2812_put_frame(pio0, m_rendered_frame.data(), m_rendered_frame.size());
}

} // namespace Divacon::Peripherals
