AlexanderKnapik/DivaConGold/src/PS4AuthConfiguration.h

#ifndef PS4AUTHCONFIGURATION_H_
#define PS4AUTHCONFIGURATION_H_

#include "utils/PS4AuthProvider.h"

namespace Divacon::Config::PS4Auth {

const Utils::PS4AuthProvider::Config config = {.enabled = false,        // Enabled
                                               .serial = {},            // Serial
                                               .signature = {},         // Signature
                                               .key_pem = R"pem()pem"}; // Pem

} // namespace Divacon::Config::PS4Auth

#endif // PS4AUTHCONFIGURATION_H_
