AlexanderKnapik/DivaConGold/src/peripherals/ButtonLeds.cpp

#include "peripherals/ButtonLeds.h"

#include "hardware/gpio.h"

namespace Divacon::Peripherals {

ButtonLeds::ButtonLeds(const Config &config, bool enable_pdloader_support)
    : m_config(config), m_enable_pdloader_support(enable_pdloader_support) {
    const uint button_mask = 0                          //
                             | 1 << m_config.pins.north //
                             | 1 << m_config.pins.east  //
                             | 1 << m_config.pins.south //
                             | 1 << m_config.pins.west;

    gpio_init_mask(button_mask);
    gpio_set_dir_out_masked(button_mask);
}

void ButtonLeds::setEnablePdloaderSupport(bool do_enable) { m_enable_pdloader_support = do_enable; }

void ButtonLeds::setButtons(const Utils::InputState::Buttons &buttons) { m_buttons = buttons; }

void ButtonLeds::update() const {
    if (m_raw_mode && m_enable_pdloader_support) {
        return;
    }

    gpio_put(m_config.pins.north, m_config.invert ? m_buttons.north : !m_buttons.north);
    gpio_put(m_config.pins.east, m_config.invert ? m_buttons.east : !m_buttons.east);
    gpio_put(m_config.pins.south, m_config.invert ? m_buttons.south : !m_buttons.south);
    gpio_put(m_config.pins.west, m_config.invert ? m_buttons.west : !m_buttons.west);
}

void ButtonLeds::update(const usb_button_led_t &raw) {
    if (!m_enable_pdloader_support) {
        return;
    }

    m_raw_mode = true;

    gpio_put(m_config.pins.north, m_config.invert ? !raw.north : raw.north);
    gpio_put(m_config.pins.east, m_config.invert ? !raw.east : raw.east);
    gpio_put(m_config.pins.south, m_config.invert ? !raw.south : raw.south);
    gpio_put(m_config.pins.west, m_config.invert ? !raw.west : raw.west);
}

} // namespace Divacon::Peripherals
