AlexanderKnapik/DivaConGold/src/peripherals/ButtonLeds.h

#ifndef PERIPHERALS_BUTTONLEDS_H_
#define PERIPHERALS_BUTTONLEDS_H_

#include "usb/device_driver.h"
#include "utils/InputState.h"

namespace Divacon::Peripherals {

class ButtonLeds {
  public:
    struct Config {
        struct {
            uint8_t north;
            uint8_t east;
            uint8_t south;
            uint8_t west;
        } pins;

        bool invert;
    };

  private:
    Config m_config;
    bool m_enable_pdloader_support;

    Utils::InputState::Buttons m_buttons{};
    bool m_raw_mode{false};

  public:
    ButtonLeds(const Config &config, bool enable_pdloader_support);

    void setEnablePdloaderSupport(bool do_enable);

    void setButtons(const Utils::InputState::Buttons &buttons);

    void update() const;
    void update(const usb_button_led_t &raw);
};

} // namespace Divacon::Peripherals

#endif // PERIPHERALS_BUTTONLEDS_H_
