AlexanderKnapik/DivaConGold/(commit log)

2025-08-22 Update to pico-sdk 2.2.0
2025-09-26 Switch to c++20
2025-09-26 clang-tidy: fix include guards
    [ButtonLeds.h, Buttons.h, Display.h, GlobalConfiguration.h, PS4AuthConfiguration.h]
2025-09-28 clang-tidy: fix clang diagnostics
    [TouchSlider.h]
2025-09-28 ws2812_pio: properly latch led data
2025-11-14 relaid out IO board
    [DivaConIO.kicad_pcb, DivaConIO.kicad_sch]
2025-11-14 documenting wiring diagram
    [DivaConIO.kicad_pcb, harness.bom.tsv]
2025-11-14 placing both I2C buses on the same connector
    [DivaConIO.kicad_pcb, DivaConIO.kicad_sch, DivaConSlider.kicad_sch, harness.bom.tsv]
2025-11-14 revision 1.0 pcb schematics and layout
    [DivaConIO.kicad_pcb, DivaConIO.kicad_sch, DivaConSlider.kicad_pcb, DivaConSlider.kicad_sch]
2025-11-14 generate revision 1.0 gerber files
    [DivaConIO-B_Cu.gbr, DivaConIO-B_Mask.gbr, DivaConIO-B_Paste.gbr, DivaConIO-B_Silkscreen.gbr, DivaConIO-Edge_Cuts.gbr, DivaConIO-F_Cu.gbr, DivaConIO-F_Fab.gbr, DivaConIO-F_Mask.gbr]
2025-11-14 update revision 1.0 wiring diagram
    [harness.bom.tsv]
2025-11-14 revision 1.1 pcb schematics and layout
    [DivaConIO-B_Cu.gbr, DivaConIO-B_Mask.gbr, DivaConIO-B_Paste.gbr, DivaConIO-B_Silkscreen.gbr, DivaConIO-Edge_Cuts.gbr, DivaConIO-F_Cu.gbr, DivaConIO-F_Fab.gbr, DivaConIO-F_Mask.gbr]
2025-11-14 generate revision 1.1 gerber files
    [DivaConIO-B_Cu.gbr, DivaConIO-B_Mask.gbr, DivaConIO-B_Paste.gbr, DivaConIO-B_Silkscreen.gbr, DivaConIO-Edge_Cuts.gbr, DivaConIO-F_Cu.gbr, DivaConIO-F_Fab.gbr, DivaConIO-F_Mask.gbr]
2025-11-14 Update and move harness from doc
    [harness-bom.csv, harness.bom.tsv]
2025-11-14 Update PCBs to purchased revision
    Main edit is using a ULN2003 NPN transistor array over discrete MOSFETs.
    This was chosen because there was limited board space to put in
    pull-down resistors on the board and it was complicating the single
    layer routing. The PCB had to be expanded to 70x75mm anyways to
    accommodate the SOIC ic anyways.
    The schematics of the IO board were also updated to use net labels over
    direct wiring. Due to the JST connectors and the Pi Pico schematic
    symbol being mirrored, it was getting too difficult to have an
    understandable schematic.
    Minor edit was changing LED_DATA to nLED_DATA to signify that it is
    an active low signal.
    [DivaConIO.kicad_pcb, DivaConIO.kicad_sch, DivaConSlider.kicad_pcb, DivaConSlider.kicad_sch]
2025-11-14 Update gerbers to purchased revision
    [DivaConIO-B_Cu.gbr, DivaConIO-B_Mask.gbr, DivaConIO-B_Paste.gbr, DivaConIO-B_Silkscreen.gbr, DivaConIO-Edge_Cuts.gbr, DivaConIO-F_Cu.gbr, DivaConIO-F_Fab.gbr, DivaConIO-F_Mask.gbr]
2025-11-14 Combined IO & Slider board PCB stencil project
    Created a solder paste stencil project that has both layers of the
    slider board and the top layer of the IO board on the same layer. This
    saves some cost in getting PCB stencils manufactured.
    [DivaConStencil-Edge_Cuts.gbr, DivaConStencil-F_Courtyard.gbr, DivaConStencil-F_Cu.gbr, DivaConStencil-F_Fab.gbr, DivaConStencil-F_Mask.gbr, DivaConStencil-F_Paste.gbr, DivaConStencil-F_Silkscreen.gbr, DivaConStencil-NPTH.drl]
2025-11-14 Move gerbers to pcb project folders
    [DivaConIO-B_Cu.gbr, DivaConIO-B_Mask.gbr, DivaConIO-B_Silkscreen.gbr, DivaConIO-Edge_Cuts.gbr, DivaConIO-F_Cu.gbr, DivaConIO-F_Fab.gbr, DivaConIO-F_Mask.gbr, DivaConIO-F_Paste.gbr]
2025-11-21 Fix slider led_data silkscreen
    Didn't indicate active low on the connector, had just "DATA" for the
    test point, and had a redundant old silk screen label from a removed
    test point location
    [DivaConSlider.kicad_pcb]
2025-12-05 Generate slider PCB 3d model
    [DivaConIO.kicad_pcb, DivaConIO.kicad_sch, DivaConSlider.kicad_pcb]
2025-12-05 Initial enclosure design
    Essentially just playing around and trying to figure out how to design
    an enclosure
    [DivaConGold.FCStd, Pantalla OLED 0.96'' 128x64.stp]
2025-12-05 Update pin numbering for DivaConGold
2025-12-12 Get project compiling without USB
    Something is wrong with the USB stdio initialisation at the moment which
    is causing a hard fault. Getting to the stage where I can compile and
    run the code before troubleshooting.
    [main.cpp, tusb_config.h]
2025-12-12 Fix reversed touch slider pins
    Previously, the slider ICs were on the front side of the PCB, but now
    they have moved to the bottom side. This means that the pins that each
    slider connected to the MPR121 is now reversed.
    [TouchSlider.cpp]
2025-12-12 Delete dead slider code
    No longer using the other ICs, so I'm deleting them from potential
    configurations. This should ideally have been handled via CMake instead.
    [TouchSlider.cpp, TouchSlider.h]
